rrivirr/sonde/README.md

# sonde and sensors

[Materials Spreadsheet](https://docs.google.com/spreadsheets/d/1BQSe4LSU1jAgRDrGNKo0JbHz0ej0PQWQ6lqQEusbqys/edit?usp=sharing)
