rrivirr/sonde/freecad designs/README.md

# case_design

[Materials Spreadsheet](https://docs.google.com/spreadsheets/d/1BQSe4LSU1jAgRDrGNKo0JbHz0ej0PQWQ6lqQEusbqys/edit?usp=sharing)
