rrivirr/sonde/case/README.md

# Case development notes

## Testing marine IP68 black plastic cable glands
DG20 for conductance sensors
DG8 for temperature sensors
Full cable gland specifications:
https://www.indexmarine.com/wp-content/uploads/2017/08/ValueRangeGlands_DG_Series_DataSheet_IMVRDG02.pdf
