rrivirr/sonde/deployment/rebar sonde deployment.png

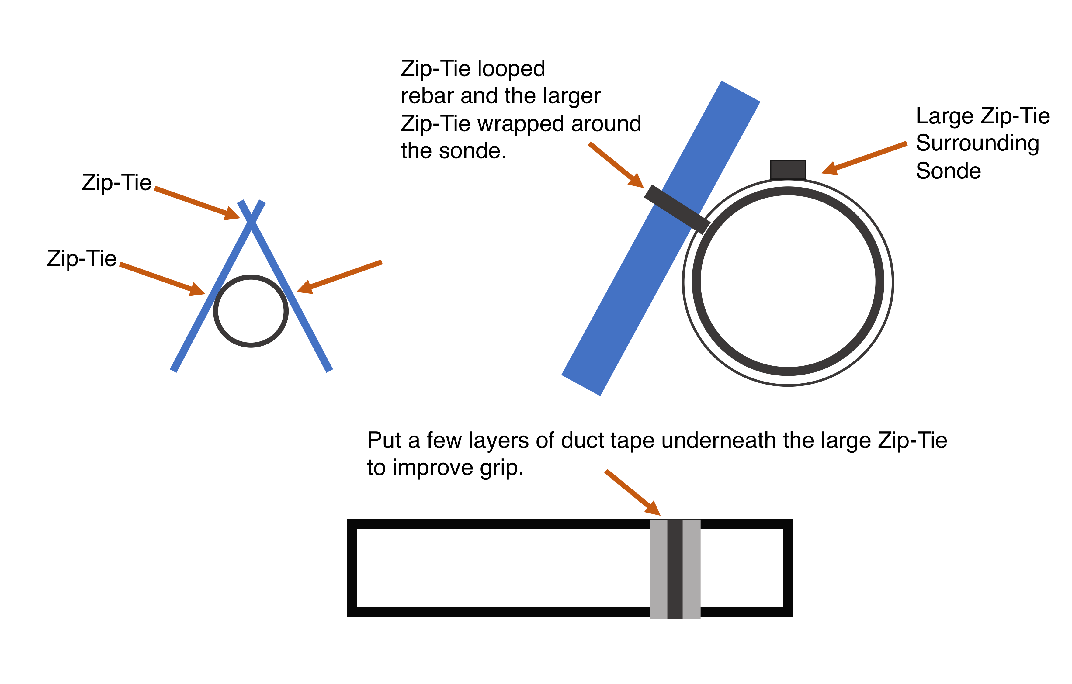
deployment/rebar sonde deployment.png
