rrivirr/sonde/case/tube cad design.FCStd

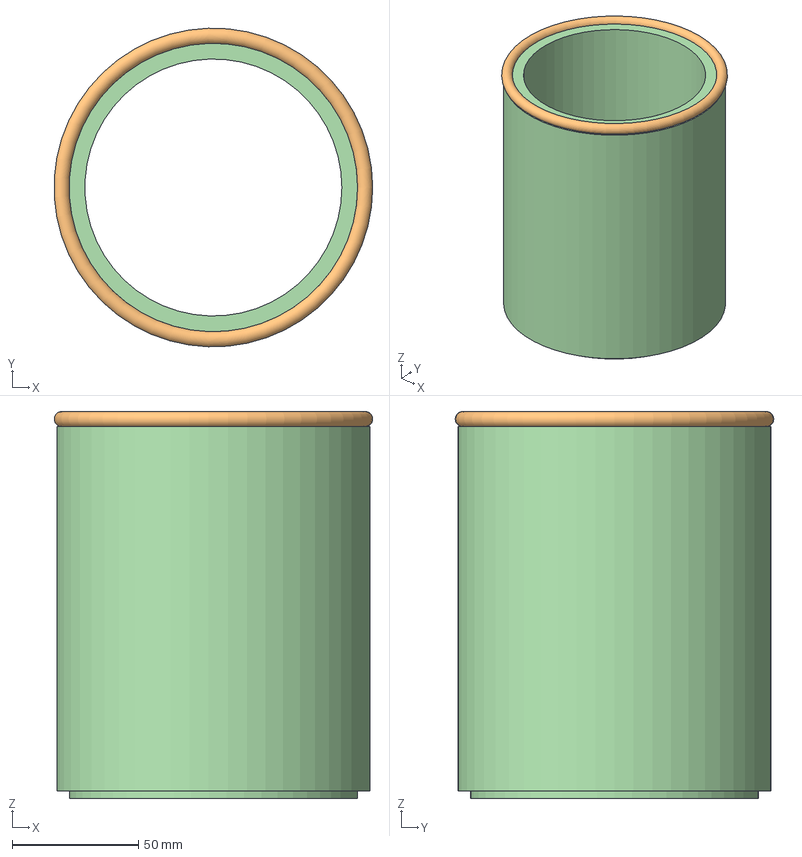
[picture p2: CAD file, 2020-08-25]
case/tube cad design.FCStd
125.9 x 125.9 x 153.0 mm
