rrivirr/sonde/freecad designs/PanelDrill.dxf

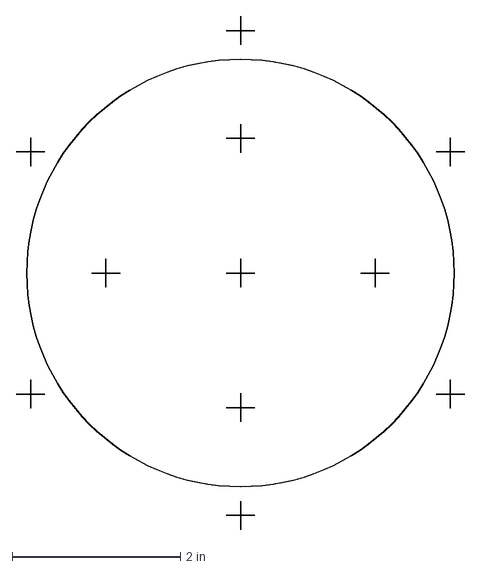
[picture p3: CAD file, 2020-08-25]
freecad designs/PanelDrill.dxf
5.33 x 6.10 in
