rrivirr/sonde/librecad designs/backplate.dxf

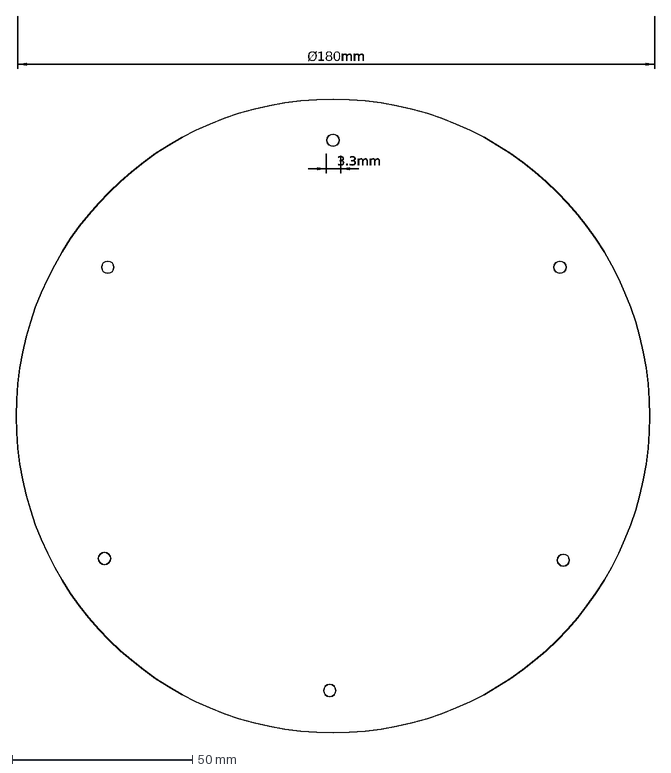
[picture p4: CAD file, 2020-12-30]
librecad designs/backplate.dxf
Ø180mm
3.3mm
