rrivirr/sonde/freecad designs/end plate.FCStd

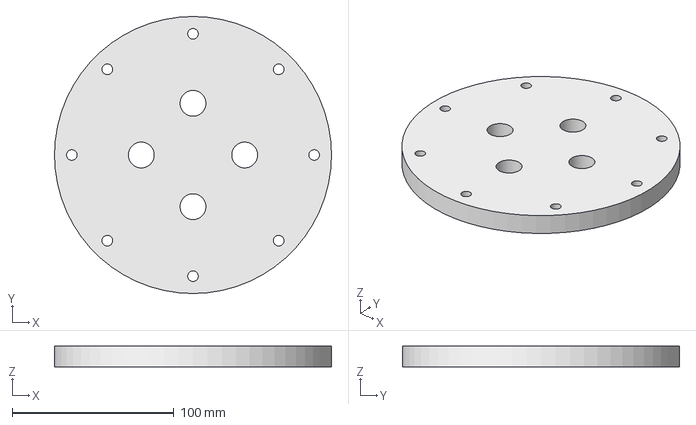
[picture p5: CAD file, 2020-08-25]
freecad designs/end plate.FCStd
171.4 x 171.4 x 12.7 mm
