rrivirr/sonde/librecad designs/frontplate.dxf

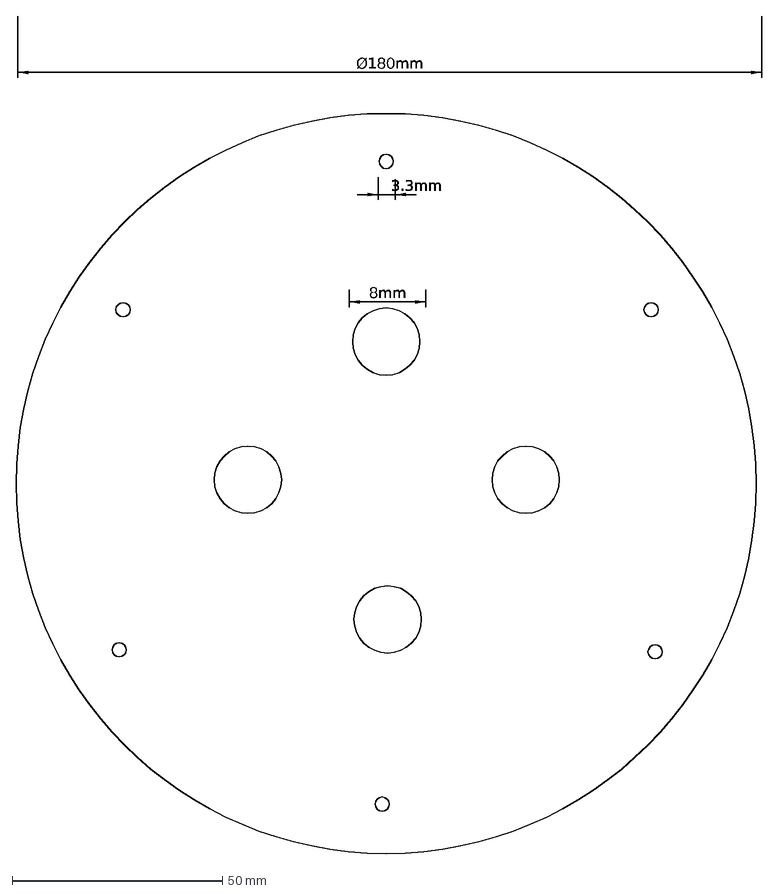
[picture p6: CAD file, 2020-12-30]
librecad designs/frontplate.dxf
Ø180mm
3.3mm
8mm
