rrivirr/sonde/panels/Panel4inch.v4.dxf

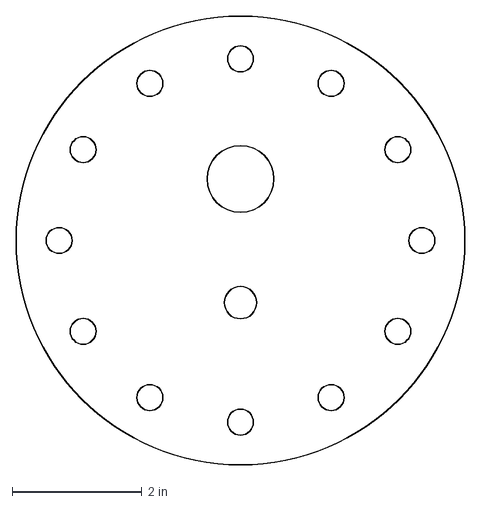
[picture p7: CAD file, 2022-10-13]
panels/Panel4inch.v4.dxf
6.92 x 6.92 in
