rrivirr/sonde/panels/panel.dxf

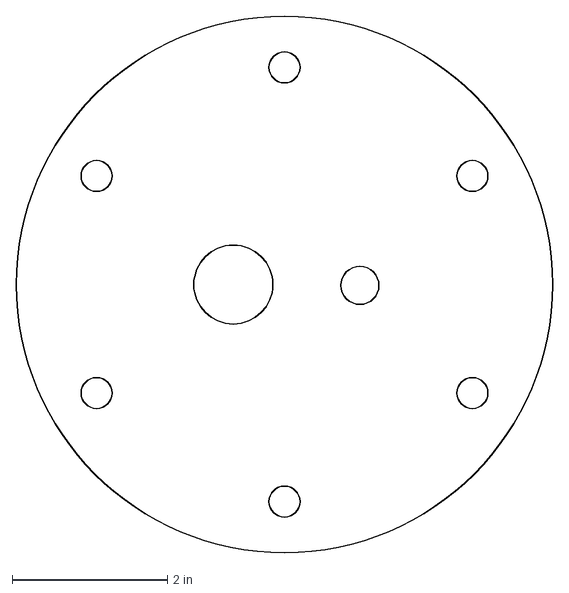
[picture p8: CAD file, 2021-02-16]
panels/panel.dxf
6.92 x 6.92 in
