rrivirr/sonde/panels/PanelDrill2.dxf

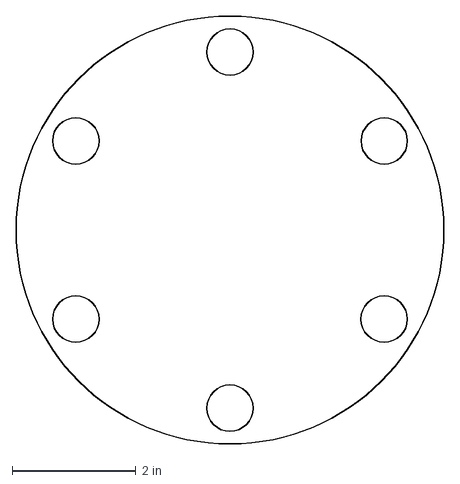
[picture p9: CAD file, 2021-01-05]
panels/PanelDrill2.dxf
6.92 x 6.92 in
