rrivirr/sonde/panels/Panel3Inch.v4.dxf

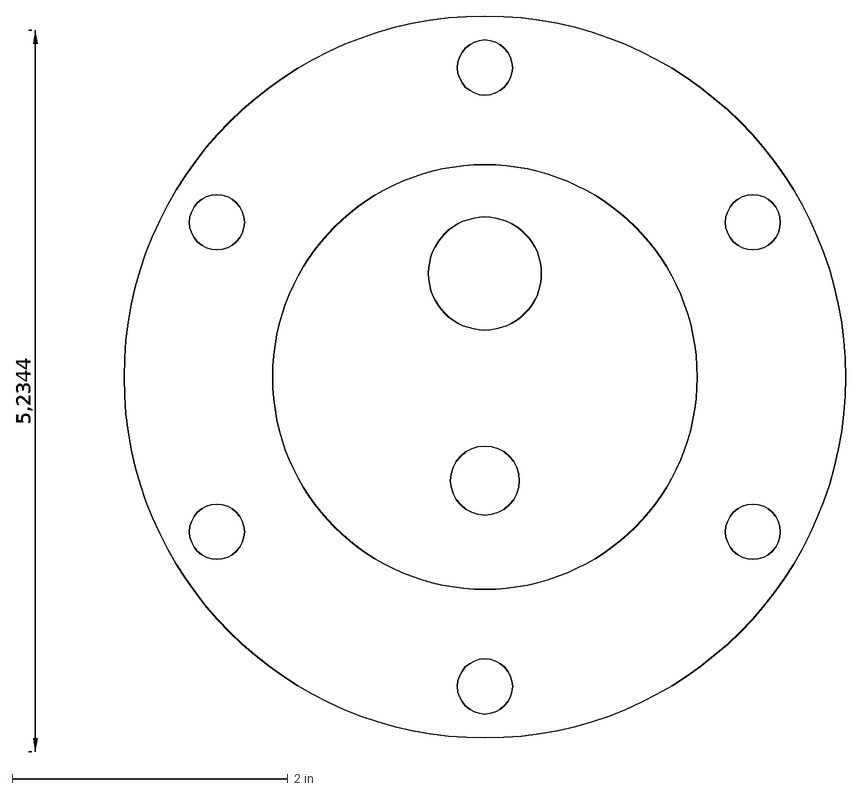
[picture p10: CAD file, 2022-07-12, an earlier design]
panels/Panel3Inch.v4.dxf
5,2344
