rrivirr/sonde/freecad designs/end plate drawing 2.pdf

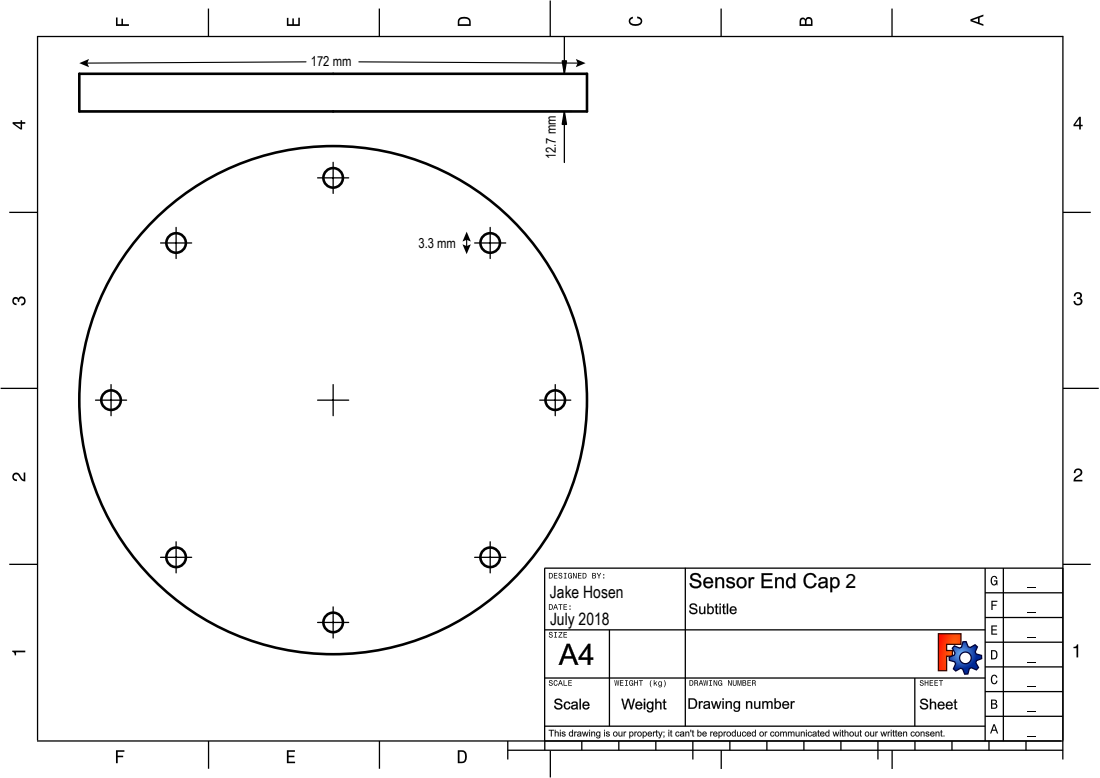
[picture p11: page 1]
Jake Hosen

July 2018 ¹².7 mm
