rrivirr/sonde/freecad designs/end plate drawing.pdf

# July 2018 ¹².7 mm

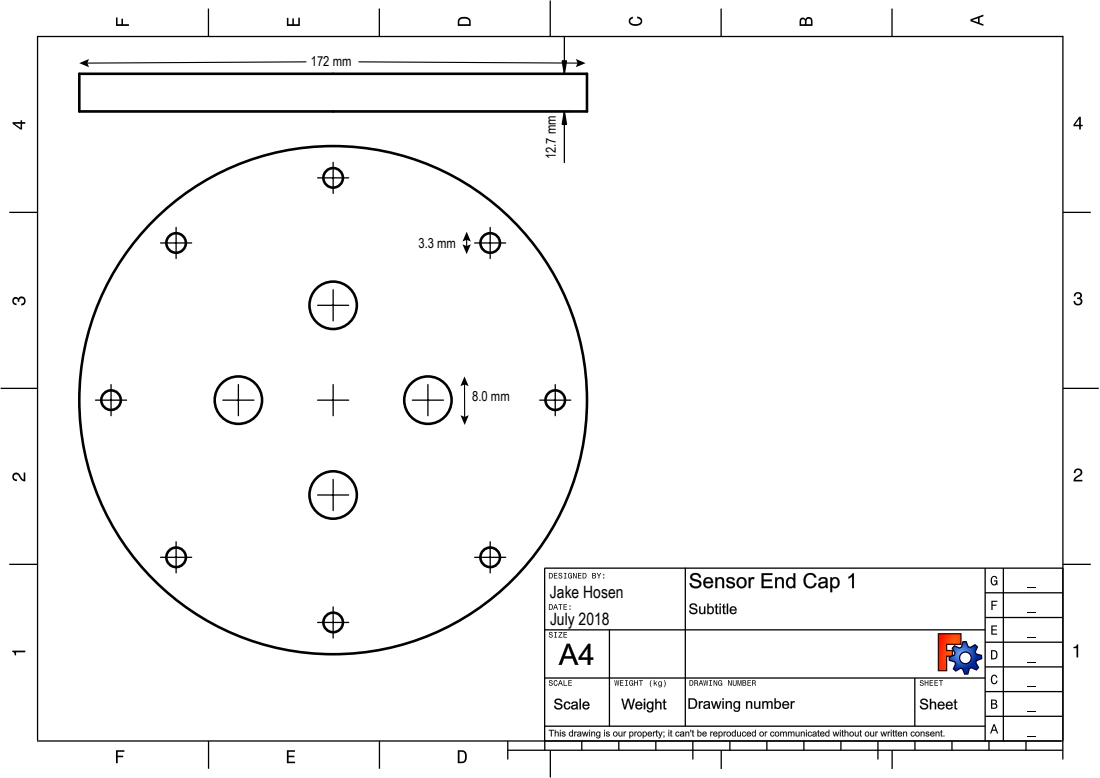
[picture p12: page 1]
Jake Hosen
