rrivirr/sonde/librecad designs/frontplate.pdf

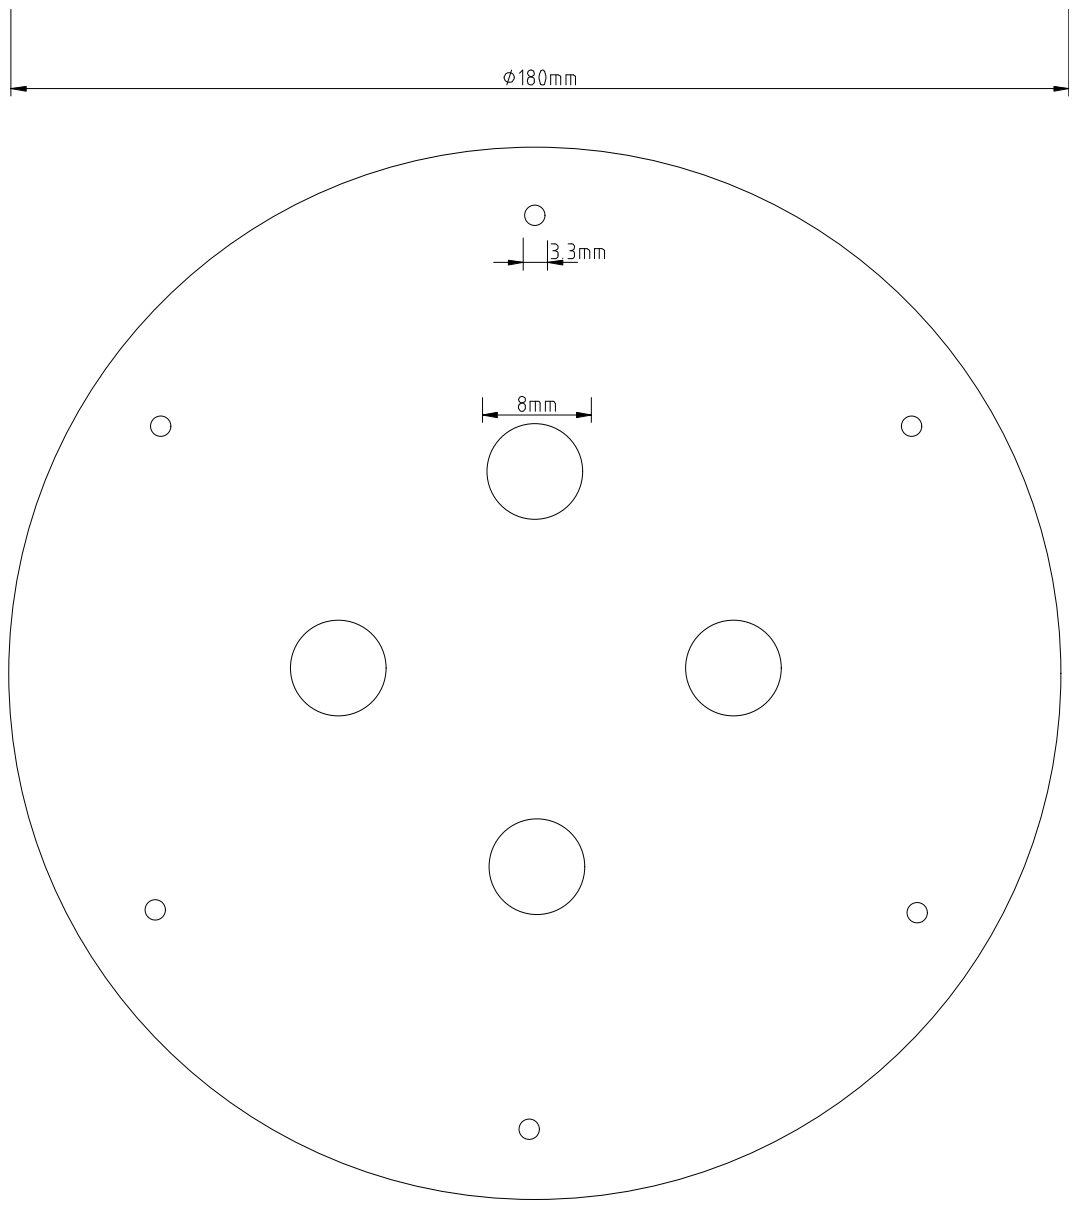
[picture p13: page 1]
