rrivirr/sonde/freecad designs/PanelDrill.pdf

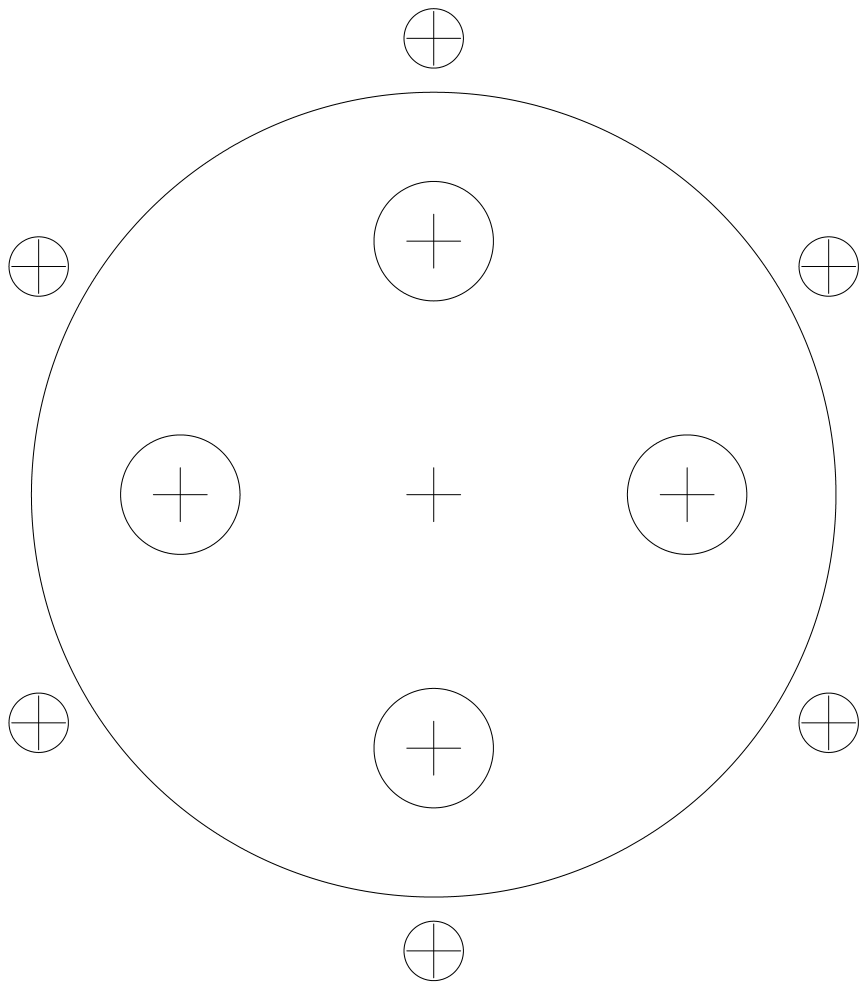
[picture p14: page 1]
