rrivirr/sonde/case/tube cad design drawing.pdf

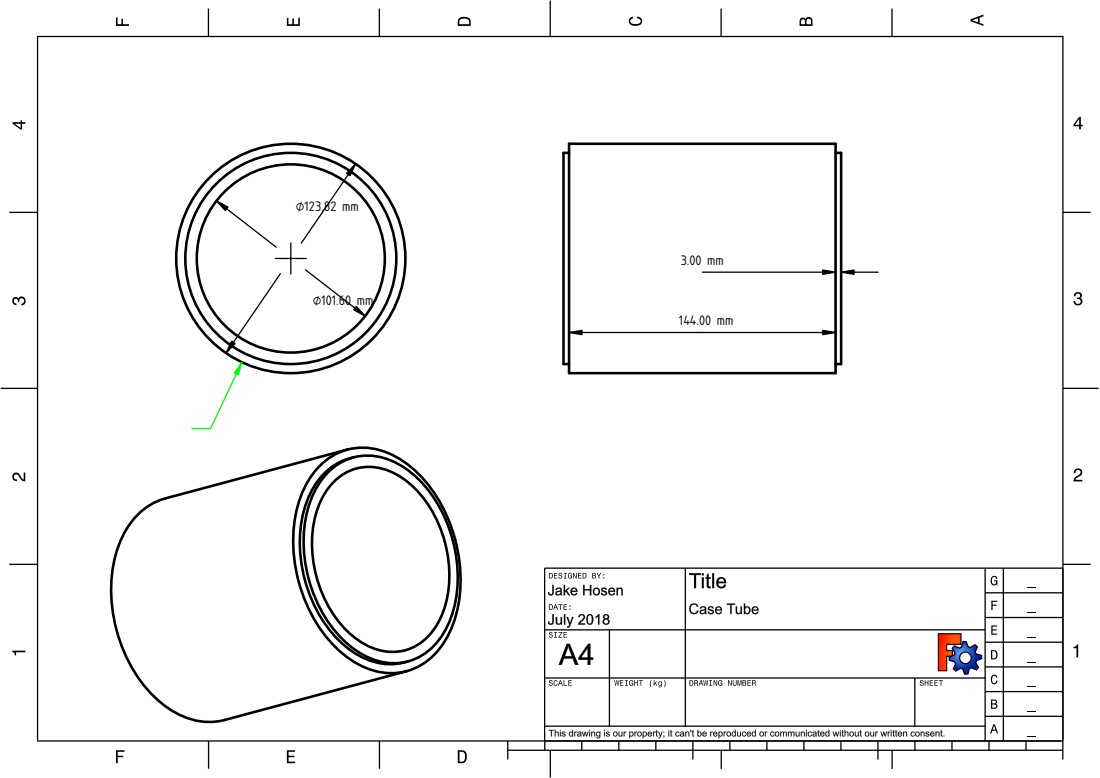
[picture p15: page 1]
