rrivirr/sonde/case/tube design.pdf

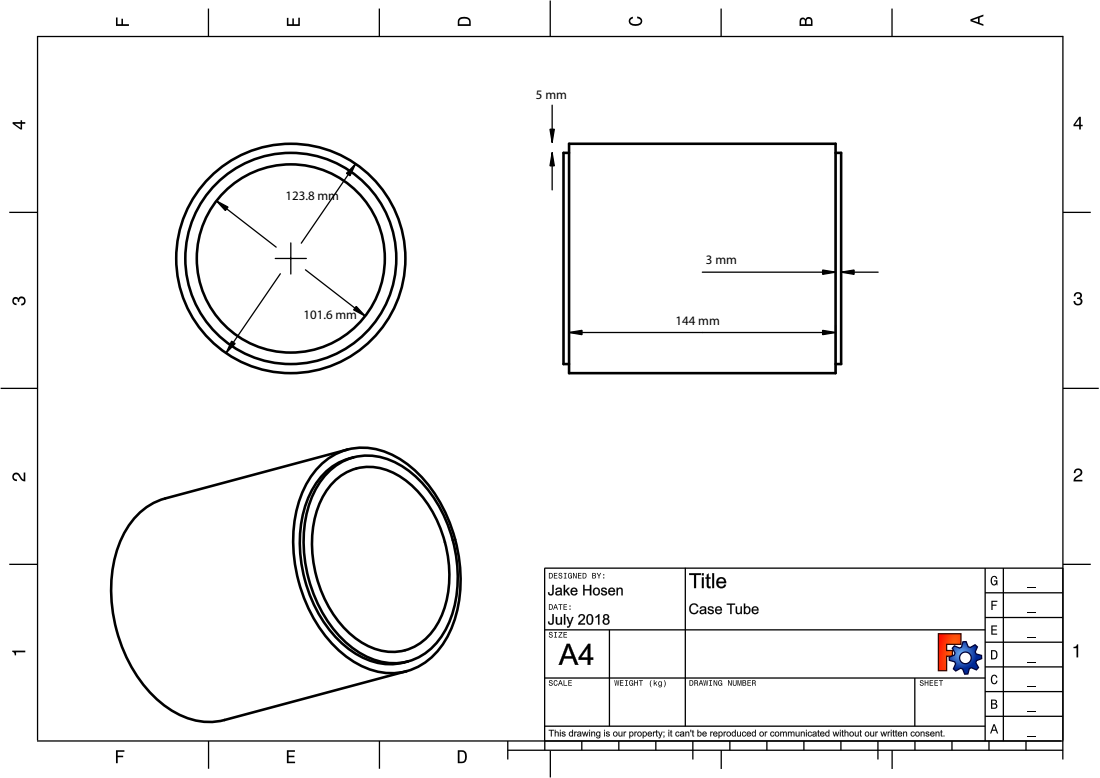
[picture p16: page 1]
