rrivirr/sonde/panels/Panel.v3.inner.pdf

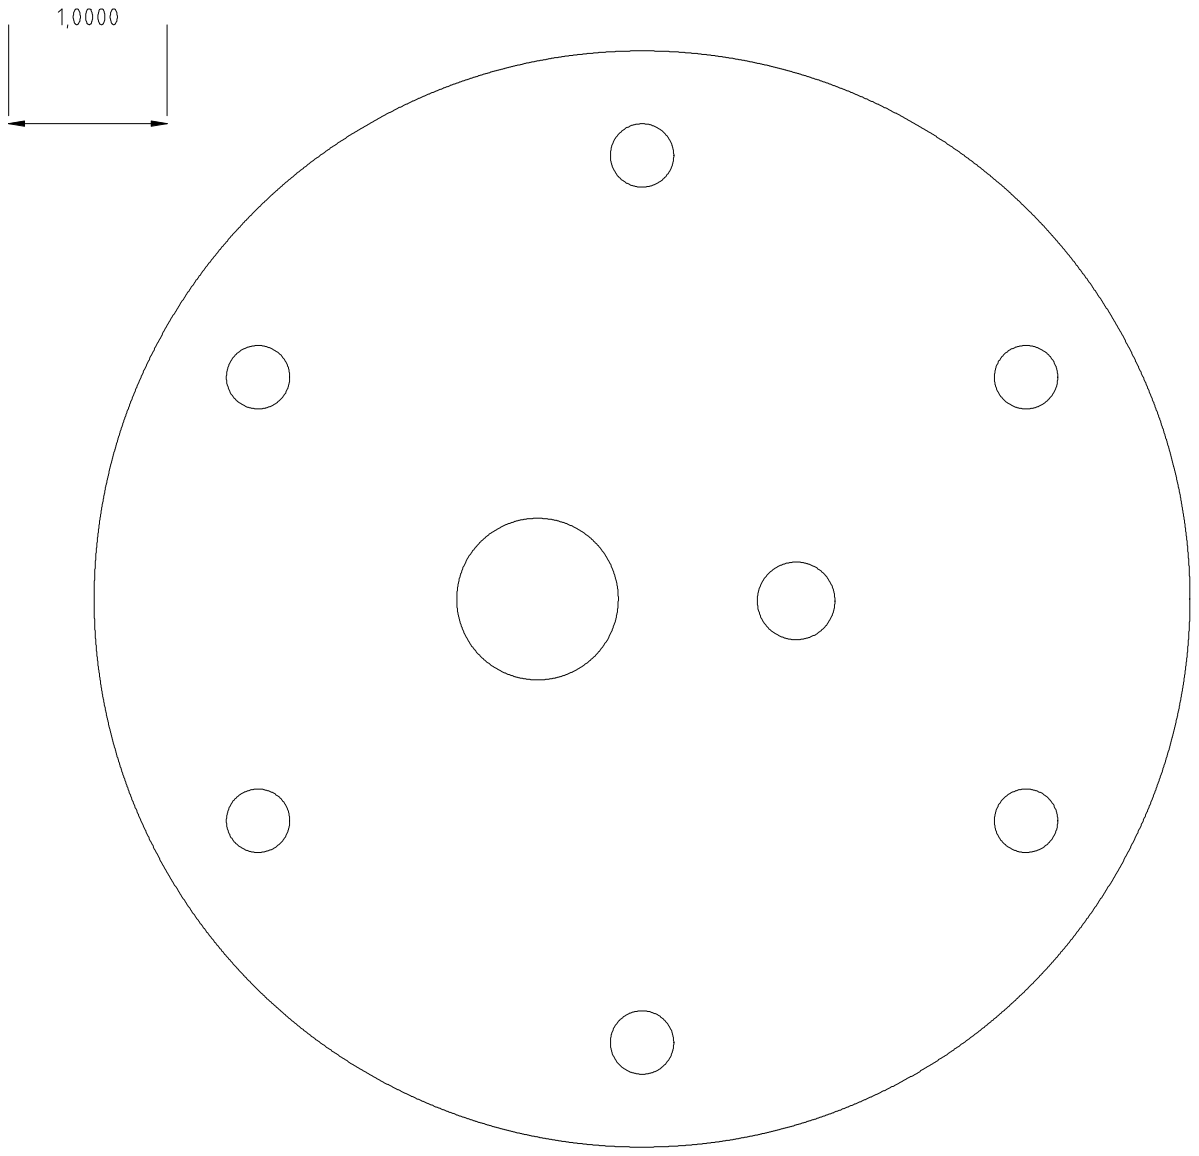
[picture p17: page 1]
