rrivirr/sonde/panels/Panel.v3.outer.pdf

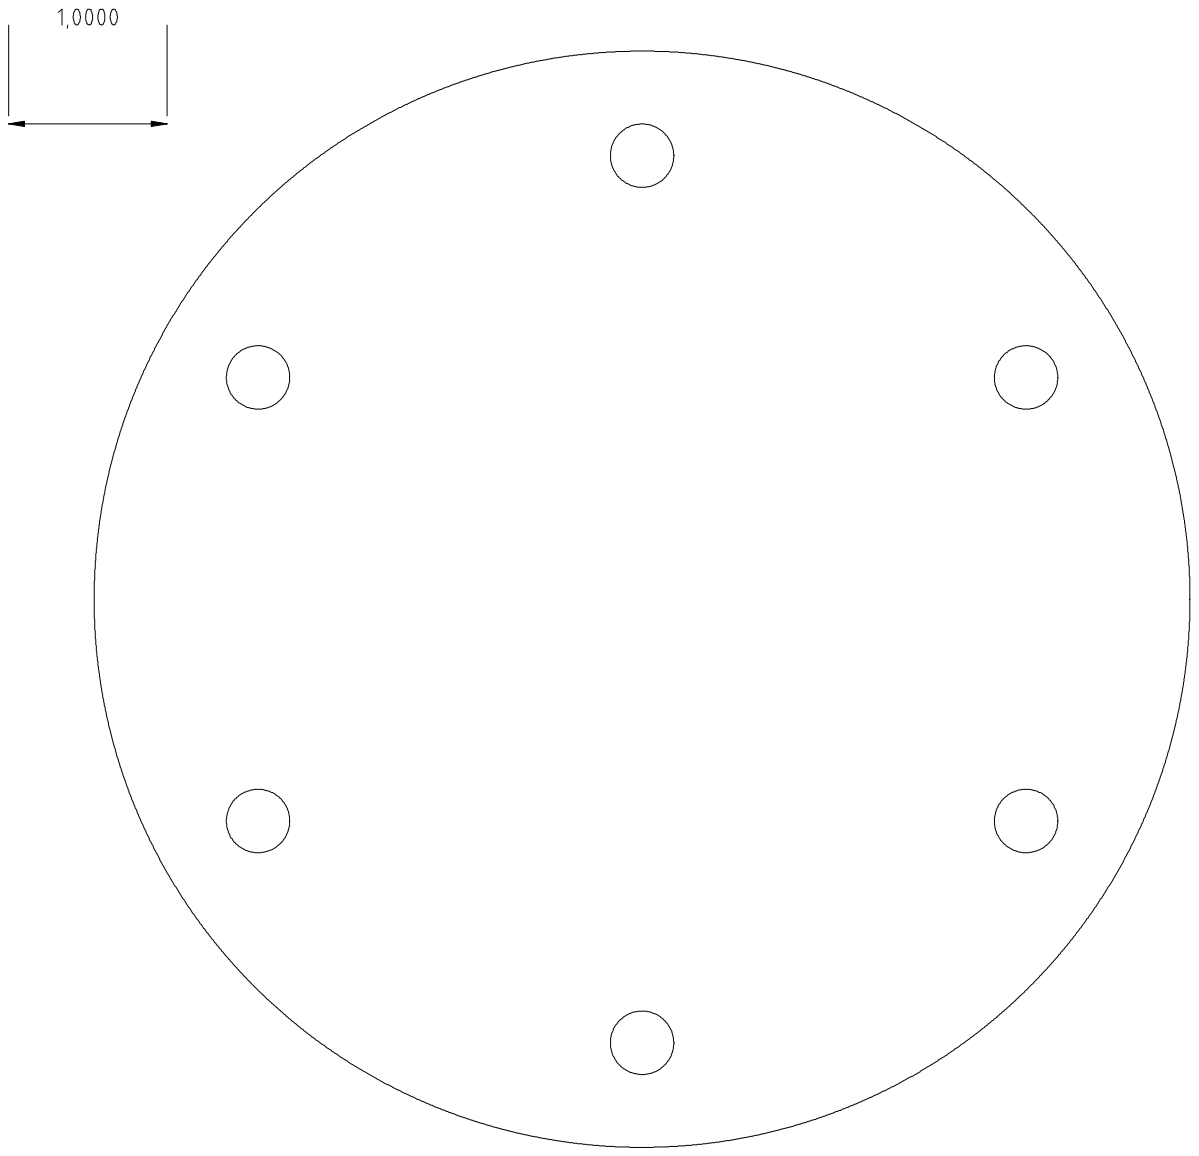
[picture p18: page 1]
