rrivirr/sonde/(threads)

Thread 2 (2022-07-15):

Start design of the measurement chamber

ZavenArra, 2022-07-15:

ZavenArra, 2022-07-15:
Materials received, focus is on code for actuator first.

emersonae, 2022-07-29:
To Do After Code Working
Build prototype of air pump
Figure out and build battery pack
Calculate volume of chamber with weight of waterbear & batteries. Calculate length of excess tubing
Build prototype chamber & attach waterbear housing  (drill holes & attach tubing. Attach pool noodles)
Test entire  chamber in water

Build all chambers

jakehosen, 2022-08-12:
Case design finished and starting to assemble. Pump is working but needs to be fully integrated with the RRIV firmware. Ordering some last nuts and bolts to get things assembled.

Thread 7 (2022-07-29):

Adjust length of case if internal components add up to be too long

kenchong48, 2022-07-29:

Thread 16 (2022-09-30):

Redesign plates to increase size of co2 gland, and reposition cable gland holes into spaces between rods and further apart, try to include guide for size of pvc/sensor cases

kenchong48, 2022-09-30:

kenchong48, 2022-09-30:
Note: the space between rods and hub is enough for a flat of a nut, but not enough to spin it, and if no nut is in place allows room for the hub to move around, which could be in a different position between top and bottom plate depending on tilt of plates
