rrivirr/sonde/(commit log)

2018-01-18 Adding instructions on case construction
2020-08-25 Added CAD drawings and designs.
    [end plate.FCStd, tube cad design.FCStd]
2020-12-30 adding librecad design used for beta version
    [PanelDrill.dxf, backplate.dxf, end plate.FCStd, frontplate.dxf, tube cad design.FCStd]
2021-01-05 Reorganized files into a descriptive structure, add the updated panel design
    [PanelDrill.dxf, PanelDrill2.dxf, backplate.dxf, end plate.FCStd, frontplate.dxf, tube cad design.FCStd]
2021-01-05 Call it panels not plates
    [PanelDrill2.dxf]
2021-01-05 Improve order of directory display
    [PanelDrill.dxf, backplate.dxf, end plate.FCStd, frontplate.dxf]
2021-01-05 Both front and back
    [panel.dxf]
2021-01-05 Slight increase in size of panel
    [panel.dxf]
2021-02-16 Fixed panel design
    [panel.dxf]
2022-07-08 feat: adding other panel files temporarily, remaking/adding gland layers for 3" and 4" cases
    [#panel.dxf, Panel3Inch.dxf, Panel3Inch.v4.dxf, Panel4inch.v4.dxf, PanelDrill.dxf, PanelDrill2.dxf, panel.dxf]
2022-07-08 fix: clearing old files
    [#panel.dxf, Panel3Inch.dxf, PanelDrill.dxf, PanelDrill2.dxf, panel.dxf]
2022-07-12 fix: correct from 0.8 to 0.82 for RDC13NR gland rather than RDM20AR
    [Panel3Inch.v4.dxf, Panel4inch.v4.dxf]
2022-07-15 Add extra holds for removable cage to 4" plate
    [Panel4inch.v4.dxf]
2022-10-13 Fix: resize and rearrange sensor gland through holes to maximize space allowed, mock up guidelines for where components would be
    [Panel3Inch.v5.dxf]
2022-10-13 fix: add sensor cage holes to 3" design, account for size of sensor housing cap in spacing out sensor gland holes
    [Panel3Inch.v5.dxf]
2022-11-03 fix: glands of 0.82" D is 0.41" R, not 0.42"
    [Panel3Inch.v5.dxf]
